nphlp/Splitergoll/docs/detection-os.md

# Diagnostic de détection d’OS

Objectif : reconnaître l’ordinateur à partir de sa connexion, sans logiciel
compagnon permanent ni changement manuel d’OS. Le diagnostic observe les échanges
et annonce une hypothèse. Avec une keymap fixe, il ne change pas les couches. Le firmware
[`auto`](keymap-auto.md) applique désormais la décision USB dans un profil expérimental.

Tous les fichiers de cette étude sont dans `diagnostics/os-signature/` :
`firmware/` pour la capture embarquée, `snippets/` pour son activation, `tests/`
pour le stockage et `capture.sh`, `capture.ps1`, `check.awk` pour les lecteurs.
L’observateur USB et le classifieur partagés sont dans `keyboard/src/os_detection/`,
leurs interfaces dans `keyboard/include/splitergoll/` et leurs tests dans `keyboard/tests/`.

## Préparer V1 en USB

```sh
make build wire macos usb-trace
make flash wire macos left usb-trace
```

La droite garde son firmware `wire` normal de la même version. Le build produit
aussi son UF2, mais seul celui de gauche ajoute le diagnostic. Aucun reset des
réglages n’est nécessaire. Sur Windows, conserver cette même keymap pour comparer
exactement le même firmware, sans attendre des raccourcis macOS qu’ils soient adaptés.

La centrale conserve les 256 premiers en-têtes SETUP de huit octets de chaque
cycle USB, avec leur ordre et un horodatage local. Aucun contenu de frappe ni
clé Bluetooth n’est enregistré. Une lecture ne vide pas cette mémoire.

## Lire une capture

Sur le Mac, identifier le port série de gauche avec `ls /dev/cu.usbmodem*`,
puis utiliser son nom exact, par exemple :

```sh
make usb capture /dev/cu.usbmodem123
```

Sous Windows, copier uniquement [capture.ps1](../diagnostics/os-signature/capture.ps1)
dans le dossier de son choix, par exemple `Documents/Splitergoll`. Aucun sous-dossier
ni autre fichier du dépôt n’est nécessaire. Ouvrir PowerShell dans ce dossier,
trouver le port gauche dans le Gestionnaire de périphériques, puis lancer :

```powershell
powershell -NoProfile -ExecutionPolicy Bypass -File .\capture.ps1 -Port COM3
```

L’option `Bypass` permet ce lancement si la politique d’exécution bloque les scripts.
Elle reste limitée au processus PowerShell lancé, sans changer la politique enregistrée.
Ce lecteur ne demande pas de terminal administrateur. Voir [la documentation Microsoft](https://learn.microsoft.com/en-us/powershell/module/microsoft.powershell.core/about/about_powershell_exe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).

Remplacer les exemples de ports par ceux réellement présents. Fermer les autres
lecteurs série. Brancher la droite sur un chargeur USB pendant cette identification
évite de confondre deux ports. Aucun logiciel supplémentaire n’est nécessaire pour
le lecteur PowerShell, le pilote série natif doit être disponible.

La capture Windows apparaît directement dans le dossier courant, sous le nom
`windows-AAAA-MM-JJ-HH-MM-SS-xxxxxxxx.txt`, avec date UTC. C’est ce fichier qu’il faut
transmettre. Le chemin du script ne détermine pas celui de la capture.
Sur macOS/Linux, `make usb capture` conserve ses fichiers dans `.local/usb-traces/`.
Le lecteur attend au plus 15 secondes la réponse après sa demande et refuse une
capture tronquée, désordonnée ou signalant des pertes. Seules les requêtes mémorisées
sont restituées, pas les frappes.

## Comparer Mac et Windows

1. Garder les mêmes UF2, câbles et branchement direct, sans hub pour le premier essai.
2. Débrancher les deux USB de V1 pour repartir d’un démarrage neuf.
3. Brancher les USB à l’ordinateur testé, attendre cinq secondes, puis lire la gauche.
4. Répéter trois fois sur le Mac, puis trois fois sur Windows. Ne pas taper pendant la capture.
5. Comparer les requêtes, leurs paramètres et leur ordre. Les temps seuls ne sont pas une signature fiable.

Une fois des différences reproductibles identifiées, tester aussi Linux, les hubs,
la reconnexion et le réveil pour élargir la validation de la reconnaissance automatique.

## Limites du diagnostic

Le port série ajoute une interface CDC ACM aux descripteurs USB. Les premières
signatures décrivent donc un clavier instrumenté, pas encore le firmware normal.
Le lecteur peut lui-même ajouter des requêtes série. Il faudra isoler ces échanges
et revalider les signatures sans cette interface avant d’en faire une fonctionnalité.
Un échec d’énumération qui empêche l’apparition du port n’est pas lisible par ce canal.
Sur V1, le firmware normal fonctionne sur macOS mais ne produit aucune saisie sur
Windows. Utiliser [la capture côté Windows](capture-usb-windows.md) avec `-UsbEvents`
pour étudier ce cas sans ajouter d’interface série au clavier.

## Résultats sur V1

Les cinq captures Mac contiennent chacune 24 requêtes, les cinq Windows 57,
58, 57, 53 et 53. Aucun rejet ni perte n’est signalé. Le lecteur PowerShell fonctionne sur
le PC. Ces captures de référence sont conservées dans `.local/usb-traces/`.

Les motifs de noms sont cohérents entre les essais. Le début de l’énumération et
les répétitions peuvent varier : la capture Windows sur le clavier commence sur 18
octets, sans sonde de 64 visible.
Les requêtes CDC sont isolées, car elles dépendent aussi du pilote et du lecteur série.

| Demande observée | Mac | PC Windows |
| --- | --- | --- |
| Début de la capture du descripteur du périphérique | 8 octets | 64 ou 18 octets selon le cycle |
| Lecture des noms du clavier | 2 octets puis lecture complète | Lectures sur 255 octets, puis 4 et complet avec CDC ou 262 sans CDC |

Le code est propre à Splitergoll, inspiré des motifs étudiés par
[QMK](https://docs.qmk.fm/features/os_detection) et
[Cormoran](https://github.com/cormoran/zmk-feature-os-detection/blob/main/docs/fingerprints.md),
puis confronté à nos captures. Aucun module externe ni changement de descripteur USB n’est ajouté.

## Comment la décision est prise

Le classifieur associe chaque sondage à sa relecture, pour le même nom et la même
langue. Deux motifs « 2 puis complet » suggèrent macOS. Windows demande deux noms
distincts sur 255 octets, avec soit un motif « 4 puis complet », soit une relecture
du même nom sur « 255 puis 262 ». Ce second motif vient de la capture du firmware
normal, sans port série. Une seule taille ou des répétitions ne suffisent pas. Les sondes
8/64 sont complémentaires : leur absence ne bloque pas la décision, leur
contradiction la rend ambiguë. Répéter un même nom ne renforce pas l’indice.
Les tailles des rapports HID et les requêtes du lecteur série sont ignorées.

Il annonce son hypothèse dès que les motifs sont suffisants, sans délai fixe.
La sélection automatique attend aussi que l’USB clavier soit prêt et que les
touches soient relâchées. Des indices insuffisants
donnent « inconnu », des motifs contradictoires donnent « ambigu ».
Un reset du bus USB ou une déconnexion efface les indices du cycle précédent.

La lecture affiche `Signature USB : hypothèse macOS` ou `Windows`. La décision est
recalculée sur l’instantané au moment de la demande de capture, pas appliquée aux couches.
L’aller-retour Mac → Windows → Mac est confirmé sur V1, sans nouveau flash entre
Windows et le retour au Mac. La sélection automatique est ensuite confirmée avec CDC.
Sans CDC, le Mac fonctionne mais Windows restait bloqué : sa capture ETW ne contient
aucun sondage sur 4 octets. Le motif « 255 puis 262 » corrige le rejeu, puis
l’utilisateur confirme la saisie et la détection Windows puis macOS avec le même
firmware normal sur V1, sans reflash entre les hôtes. Il signale ensuite un délai
irrégulier de démarrage sur Mac, même de Mac vers Mac. Ce cas reste ouvert,
sans preuve d’une ancienne sélection Windows conservée. Linux et les hubs restent à tester.
Avec `wire auto usb-trace`, une ligne `Keymap automatique appliquée` indique la
sélection réelle. Un résultat en attente signifie qu’aucun OS n’est encore activé.

Le script `.ps1` est enregistré en UTF-8 avec BOM pour les accents sous Windows
PowerShell. Les fichiers de capture restent en UTF-8 sans BOM pour leur analyse.
Le lecteur mis à jour et l’affichage des accents sont confirmés sur le PC.

## Suite Bluetooth

Le [protocole Bluetooth](detection-os-bluetooth.md) décrit le firmware `ble-trace`
et la lecture des premiers appairages et reconnexions sur Mac puis Windows.

V1 peut aussi tester le Bluetooth direct avec ses deux USB pour l’alimentation,
sans batterie. Ce sera une capture BLE distincte, pas une détection de l’OS
Bluetooth à partir du chargeur ou de l’ordinateur qui fournit son USB.

Pour revenir à l’usage normal : `make flash wire macos left`.
