nphlp/Splitergoll/docs/keymap-auto-bluetooth.md

# Keymap automatique Bluetooth

`bluetooth auto` réunit macOS et Windows avec gaming. Il utilise l’OS mémorisé
de l’appareil Bluetooth sélectionné. L’ordinateur qui alimente l’USB ne détermine
pas la keymap. Sur V1, l’utilisateur confirme la bascule entre Mac et Windows avec
la bonne keymap pour chaque appareil, avec le firmware `ble-trace`.

```sh
make build bluetooth auto
```

## Fonctionnement

Au premier appairage, le clavier observe les services demandés et
[mémorise l’OS reconnu](memoire-os.md). Aux reconnexions et après redémarrage,
il reprend exclusivement cet OS. Les appairages et enregistrements déjà créés
par notre diagnostic sont compatibles, aucun reset n’est nécessaire.

Le nouveau firmware ouvre [dix secondes de connexion](reconnexion-bluetooth.md)
au démarrage et avec le raccourci : retour des connus et accueil des nouveaux sur
un slot libre, sans détourner la saisie. L’OS est acquis directement pendant ce nouvel
appairage, le détour par un diagnostic fixe n’est plus nécessaire. Cette extension
reste à valider sur le clavier.

Une fois la connexion sécurisée et sa mémoire vérifiée, les couches du bon OS
deviennent disponibles. Les affectations sont partagées avec les profils fixes,
y compris le pavé numérique et le gaming Windows.

Un appareil sans OS mémorisé, une erreur ou un résultat inconnu laisse les touches
en attente, sans choisir Windows par défaut. La correction manuelle viendra plus tard.
La fin des touches maintenues et des comportements différés précède toute bascule.
Aucun délai fixe de détection n’est ajouté au démarrage.

Depuis la base, **L1 + clic encodeur droit**, puis relâchement, sélectionne le prochain ordinateur
actuellement connecté. Un appareil seulement appairé est ignoré. Ce raccourci est
validé sur V1 entre Mac et Windows. La [sélection automatique d’appareil](selection-appareil.md)
reste à développer.
Le profil garde la saisie Bluetooth pendant la charge USB et ses délais de veille normaux.

## Essais complémentaires

Commencer avec le port de contrôle, sans changer les appairages :

```sh
make build bluetooth auto ble-trace
make flash bluetooth auto right ble-trace
make flash bluetooth auto left ble-trace
```

Flasher chaque moitié séparément. Garder l’USB gauche au Mac, même pour Windows.
Utiliser le clavier intégré du Mac pour piloter les essais :

```sh
make ble profiles /dev/cu.usbmodem1101
make ble memory /dev/cu.usbmodem1101
make ble select /dev/cu.usbmodem1101 1
```

Adapter le port et l’index au statut réel, ici Mac 0 et Windows 1. Une fois connecté,
le clic droit doit afficher Windows. Tester Control, le gaming et le retour à sa base.
Revenir au Mac avec le même sélecteur sur 0, puis vérifier l’affichage macOS et Command.
Ne pas taper sur Splitergoll pendant les changements de destination.
Si Windows est déconnecté après la fermeture de la fenêtre, faire L1 + clic droit
pour la rouvrir avant de le reconnecter. Une sélection USB seule ne l’ouvre pas.

Le diagnostic de session Windows peut rester inconnu en reconnexion : la décision
vient de `stored=windows`, pas d’une nouvelle reconnaissance. Les essais avec
touches maintenues, redémarrage et firmware normal complètent cette validation.
V2 sur batterie, Linux et d’autres ordinateurs restent à tester.

Pour les essais actuels, suivre [le protocole de connexion](tests-connexions-bluetooth.md).
Il distingue bascule entre deux hôtes prêts, saisie immédiate, recherche d’un connu
et nouvel appairage. Le diagnostic ponctuel a une fenêtre de dix secondes, les
builds normaux trente secondes. Avec un seul hôte prêt, le raccourci sélectionne
la première autre arrivée utilisable. Avec plusieurs, il choisit le suivant déjà prêt.
