nphlp/Splitergoll/Design PCB/img/split wireless keyboard.png

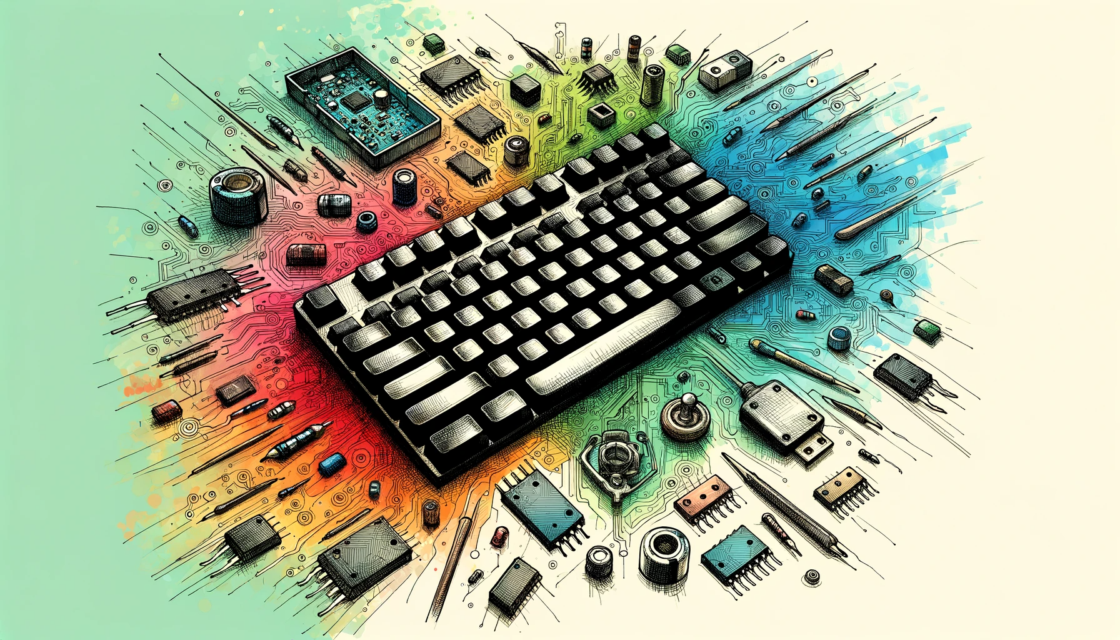
Design PCB/img/split wireless keyboard.png
