nphlp/Splitergoll/Design PCB/img/split wireless keyboard_ mini.png

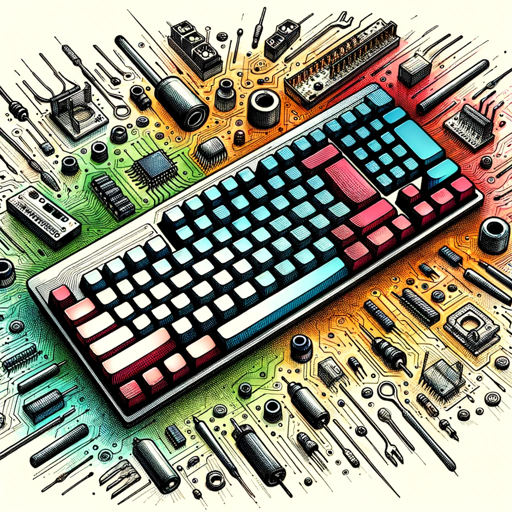
Design PCB/img/split wireless keyboard_ mini.png
