nphlp/Splitergoll/Design 3D/Splitergoll v101.3mf

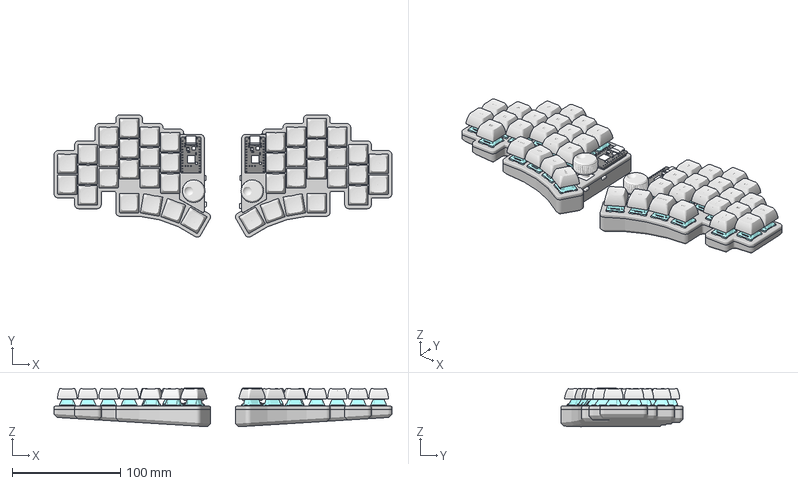
[picture p9: CAD file, 2026-10-15]
Design 3D/Splitergoll v101.3mf
311.6 x 112.8 x 35.5 mm
Barrette (1) x 2
Barrette (2) x 2
Barrette (3) x 2
Barrette x 2
Battery (L)
Battery (R)
Cache (L)
Cache (R)
Case (L)
Case (R)
Corps1 x 100
Corps10 x 2
Corps11 x 2
Corps12 x 2
Corps13 x 2
Corps14 x 2
Corps15 x 2
Corps16 x 2
Corps17 x 2
Corps18 x 2
Corps19 x 2
Corps2 x 52
Corps20 x 2
Corps21 x 2
Corps22 x 2
Corps23 x 2
Corps24 x 2
Corps25 x 2
Corps26 x 2
Corps27 x 2
Corps28 x 2
Corps29 x 2
Corps3 x 52
Corps30 x 2
Corps31 x 2
Corps32 x 2
Corps33 x 2
Corps34 x 2
Corps35 x 2
Corps38 x 2
Corps39 x 2
Corps4 x 44
Corps5 x 46
Corps7 x 2
Corps8 x 2
Corps9 x 2
Encoder (L)
Encoder (R)
Grid (L)
Grid (R)
Lettre ,
Lettre .
Lettre :
Lettre ;
Lettre A
Lettre ALT
Lettre B
Lettre BACK
Lettre C
Lettre CTRL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
