nphlp/Splitergoll/Design PCB/SplitErgoLL_v2.step

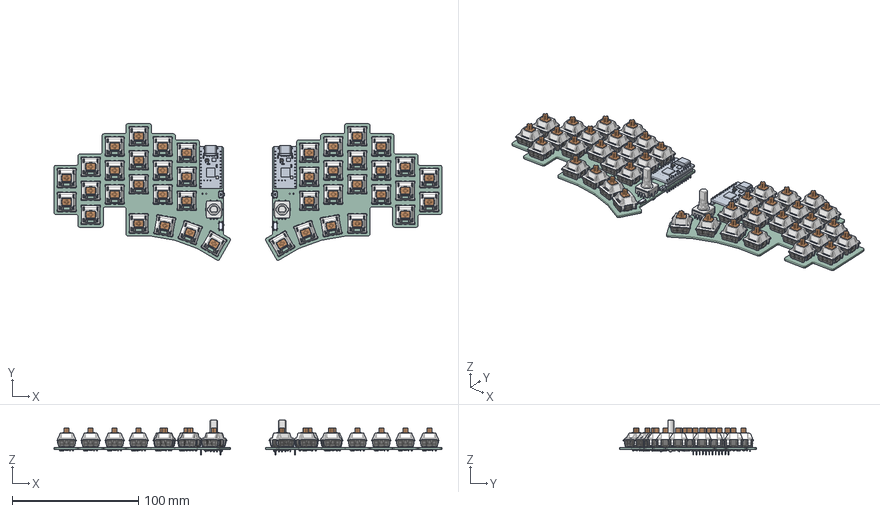
[picture p10: CAD file, 2026-10-15]
Design PCB/SplitErgoLL_v2.step
307.0 x 108.2 x 27.5 mm
SplitErgoLL_v2 PCB1
SplitErgoLL_v2 PCB2
