nphlp/Splitergoll/(list of files, cad)

Other CAD files:
design-3d/Splitergoll v101.f3z
