nphlp/Splitergoll/docs/build-local.md

# Build local

Le Makefile lance Docker, puis `west`, l’outil de build de ZMK/Zephyr.
CMake prépare la compilation et Ninja utilise le compilateur ARM pour produire
les fichiers UF2. GitHub Actions n’est pas nécessaire.
Le dossier `.github/` a été retiré : aucun workflow GitHub Actions ne fait partie
de cette branche. Son ancienne matrice `build.yaml` a également été retirée.

## Utilisation

Prérequis : Make, Bash, Docker démarré, `shasum` et un terminal macOS/Linux.
Sur Windows, utiliser WSL avec Docker. La validation Windows reste à faire.

Commande : `make build <matériel> <keymap> [debug|usb-trace|ble-trace|identity|usb-priority]`.
Le matériel et la keymap sont obligatoires, dans cet ordre. Aucun choix par défaut.

```sh
make setup
make build wire macos
make build bluetooth windows debug
```

- `setup` télécharge l’image et les sources figées.
- Le matériel `wire` choisit une sortie USB à gauche, `bluetooth` une sortie Bluetooth directe.
- La keymap doit être `auto`, `multi`, `windows`, `macos` ou `linux`.
- `auto` sélectionne macOS ou Windows avec gaming : par [signature USB](keymap-auto.md)
  en `wire`, ou par [OS mémorisé de l’appareil sélectionné](keymap-auto-bluetooth.md) en `bluetooth`.
- `windows` comprend le gaming. Les profils macOS et Linux restent sur leur OS.
- Ajouter `debug` après la keymap active les logs USB, voir [logs-usb.md](logs-usb.md).
- `identity`, réservé à `bluetooth auto`, ajoute les canaux d’[identité USB/BLE](diagnostic-identite.md)
  sur la gauche, sans saisie USB ni logs série. La droite reste normale.
- `usb-priority`, réservé à `bluetooth auto`, active la [priorité USB](priorite-usb.md)
  pour le même ordinateur déclaré par l’app. Deux interfaces HID à gauche, sans port série.
- `usb-trace`, réservé à `wire`, enregistre les requêtes de connexion de la gauche
  et affiche aussi la sélection appliquée avec `auto` : voir [le diagnostic d’OS](detection-os.md).
- `ble-trace`, réservé à `bluetooth`, garde les échanges de découverte de l’hôte
  sur la gauche. Il observe la keymap choisie au build, fixe ou `auto` : voir
  [le diagnostic Bluetooth](detection-os-bluetooth.md).
- `build` seul affiche l’aide, sans compilation ni Docker. Un choix incomplet ou invalide échoue avant Docker.
- `stop` arrête les conteneurs de build de ce checkout, en conservant les fichiers.
- `clear` les arrête puis supprime `.local/` et `dist/` pour toutes les versions.
- `make -n build bluetooth multi` affiche les commandes sans les exécuter.
- `make help` affiche l’aide colorée. Les commandes batterie sont décrites dans [batteries.md](batteries.md).

Après le premier `setup`, choisir le profil à compiler tant que les versions restent les mêmes.
Un seul `setup` prépare les deux profils. Lancer la compilation
avec `make build wire macos` ou `make build bluetooth windows`, par exemple.
Chaque profil conserve son propre dossier de sortie et ses journaux.
Après `make clear`, recommencer par `make setup`. L’image Docker reste disponible.
Le nettoyage refuse les liens symboliques et tout conteneur restant qui utilise le dépôt.

Chaque action Docker utilise un conteneur éphémère, supprimé à sa sortie grâce à `--rm`.
Chaque build explicite compile les deux moitiés du profil choisi.
Les logs restent visibles dans le terminal. Un label identifie le checkout pour
que `stop` cible ses seuls conteneurs de build.

Les quatre étapes affichent leur durée. En terminal interactif, les huit dernières
lignes défilent puis se replient après réussite. En cas d’échec, la sortie complète
est affichée. Sans terminal interactif, tous les logs défilent normalement.
Les journaux complets et les durées restent dans `.local/logs/` jusqu’au prochain `clear`.
Les validations sont vertes, les avertissements jaunes et les erreurs rouges.
Les couleurs sont désactivées sans terminal compatible ou avec `NO_COLOR=1`.

Si Docker affiche `DOCKER_INSECURE_NO_IPTABLES_RAW`, ce réglage vient de son moteur.
Il désactive certaines protections réseau iptables, pas la vérification des sources.
L’avertissement reste visible. Aucun port n’est publié par les conteneurs Splitergoll.
Voir [l’explication des mainteneurs Docker](https://github.com/moby/moby/pull/49621).
Le diagnostic sur le moteur OrbStack n’a pas identifié de réglage exposé pour
corriger ce drapeau. Ce point reste ouvert côté moteur, sans modification système.

Le build migré conserve deux avertissements du socle : `KSCAN` est déprécié et
les tap-dances ZMK émettent un avertissement de qualification `const`.
Ils restent visibles. Leur résolution est distincte de cette migration, voir
[les détails et validations](migration-zmk.md). L’avertissement GPREGRET a disparu.

Le dépôt est monté en lecture seule. Les dépendances et caches sont dans `.local/`.
Le snapshot ZMK `4dd95d7840eb`, basé sur Zephyr 4.1 avec correctifs ZMK,
et ses dépendances sont verrouillés dans `keyboard/west.yml`.
L’image officielle est figée par son digest dans `scripts/build-common.sh`.

Ces hashes identifient les commits et l’image exacts pour retrouver le même
environnement à chaque build. Cette version prépare ZMK 0.4, elle n’est pas une
release stable publiée. Le manifeste détaille 68 projets, dont 45 actifs,
pour verrouiller aussi les dépendances indirectes. L’image officielle 4.1 et
la cible `nice_nano@2.0.0//zmk` remplacent le socle 3.5 et `nice_nano_v2`.
Le [snapshot stable 0.3](firmwares-stables.md) reste récupérable dans l’historique Git pour revenir en arrière.

## Organisation

`keyboard/` regroupe les keymaps et profils dans `config/`, les shields dans
`boards/`, leur déclaration de module dans `zephyr/` et le manifeste `west.yml`.
L’étude des signatures
est séparée dans `diagnostics/os-signature/`, son firmware n’est ajouté qu’aux builds `usb-trace` et `ble-trace`.

Chaque commande a sa propre cible dans le Makefile et appelle directement son script.
Les sections séparent aide, Firmware, Batteries (bat/app) et Debug (port/usb/ble). Les mots après la
première commande sont uniquement ses arguments : `make app build` ne lance pas
le build firmware. Les scripts contrôlent leurs arguments avant toute action.
`make app`, `make bat`, `make usb` et `make ble` affichent leurs aides, de même
qu’une sous-commande erronée. Celle-ci renvoie aussi un statut d’erreur.

Les scripts se répartissent ainsi :

- `scripts/help.sh` et `terminal-colors.sh` : aide colorée et palette partagée avec les journaux.
  `make port` explique comment trouver le port série du clavier, sans ouvrir de connexion.
- `scripts/build-common.sh` : constantes de chemins et d’image, contrôles et lancement Docker.
- `scripts/build-logs.sh` : affichage des étapes, durées et journaux complets.
- `scripts/setup.sh` : préparation des dépendances.
- `scripts/build.sh` : compilation et récupération des UF2.
- `scripts/flash.sh` et `uf2-check.awk` : sélection, contrôle et copie d’un UF2 après confirmation sur macOS, voir [le flash](flash-firmware.md).
- `scripts/container.sh` : commandes `west` et contrôles dans le conteneur.
- `scripts/stop.sh` : arrêt des conteneurs de build du checkout.
- `scripts/clear.sh` : arrêt et suppression des fichiers locaux générés.
- `scripts/batteries.sh` : `make bat read` et `make bat avg`, sans Docker.
- `companion/macos/app.sh` : `make app start`, `build` et `test`.
- `diagnostics/os-signature/usb.sh` et `ble.sh` : sous-commandes de diagnostic.

Les chemins locaux sont calculés depuis le dépôt. Aucun `.env` n’est nécessaire.
Les caches CMake du nouveau rangement utilisent `build/keyboard/` dans le workspace
préparé. Les anciens caches sont conservés, un nouveau `make setup` n’est pas nécessaire.
`make build bluetooth multi` appelle `build.sh bluetooth multi`, `make bat avg` appelle
`batteries.sh avg`. Les scripts refusent les arguments qu’ils ne prennent pas en charge.

## Profils matériels

| Profil | Sortie de la gauche | Veille profonde | Batterie |
| --- | --- | --- | --- |
| `wire` | USB vers l’ordinateur | Désactivée | Reporting désactivé |
| `bluetooth` | Bluetooth direct, même pendant la charge USB | Après 10 minutes sur batterie | Reporting activé |

Dans les deux cas, la droite communique avec la gauche en BLE. Le choix de keymap
est indépendant : `multi` conserve la référence de `dongle`, les autres profils
gardent un seul OS. `keyboard/config/splitergoll.conf` contient le socle commun,
les fichiers des moitiés fixent leurs rôles, et `keyboard/config/profiles/<profil>.conf`
est ajouté en dernier via `EXTRA_CONF_FILE`. Le nom du profil est transmis
au script Docker comme argument. Les versions ZMK et l’image restent identiques.
Le build charge aussi `keyboard/config/profiles/<profil matériel>-<moitié>.conf` lorsqu’il
existe. `bluetooth-left.conf` active la récupération et le proxy de batterie sur
la centrale seulement. L’option `debug` ajoute le snippet natif `zmk-usb-logging`
au même profil. Elle a ses propres caches et sorties, sans changer les délais.
`KEYMAP_FILE` désigne `keyboard/config/keymaps/<keymap>.keymap` dans ZMK. La commande vérifie
que CMake a bien utilisé ce fichier avant d’exporter les UF2.
`make build` seul affiche l’aide. Chaque compilation demande un matériel et une keymap explicites.
`dongle` sera ajouté plus tard.

## Résultat

Chaque build crée un dossier `dist/firmware/<matériel>-<keymap>-AAAA-MM-JJ-HH-MM-SS/`,
avec un horodatage utilisant l’heure locale de la machine.
Le dossier contient :

- `splitergoll-<matériel>-<keymap>-left.uf2`
- `splitergoll-<matériel>-<keymap>-right.uf2`
- `SHA256SUMS` : empreintes des deux firmwares
- `build-info.txt` : matériel, keymap, diagnostic et identifiant de l’environnement utilisé

Avec `debug`, le nom du profil porte le suffixe `-debug` dans le dossier et les UF2,
par exemple `bluetooth-macos-debug-AAAA-MM-JJ-HH-MM-SS/` et
`splitergoll-bluetooth-macos-debug-left.uf2`. Le nom inclut toujours la keymap,
y compris `multi`, pour éviter de confondre les firmwares.

Si deux exports utilisent la même seconde, le second échoue sans écraser le premier.
Relancer la même commande de build avec son profil pour obtenir un nouvel horodatage.

Les caches sont séparés par version, matériel, keymap, diagnostic et moitié. Les dépendances modifiées
bloquent le build. Les rôles USB/BLE sont contrôlés après compilation.
Le build ne flashe rien et ne supprime aucun appairage.

Validation de migration : le setup passe sur le Mac ARM et les 32 UF2 compilent,
soit les deux matériels, quatre keymaps, normal/debug et deux moitiés.
Rôles, sorties, délais, proxy batterie, logs, bootloader, partitions, empreintes
et blocs UF2 sont contrôlés. Les keymaps compilées, macros et paramètres matériels
sont comparés au snapshot stable. Le nouveau verrouillage des couches est désactivé
pour conserver leur comportement précédent.

V1 en `wire macos` est flashé et les essais rapportés sont positifs : voir
[les essais wire](tests-wire.md). Les autres profils restent à tester.
Sur V2 après migration, les deux niveaux de [batterie](batteries.md), la reprise
après inactivité et le réveil par la gauche sont aussi rapportés sur batterie.
La droite ne réveille pas la centrale en [veille profonde](veille.md).
La première frappe et toutes les sources de réveil restent à vérifier séparément.
L’arrêt avec `stop` pendant un build reste aussi à valider.
Voir [le matériel](configuration-materielle.md), [la keymap](keymap.md) et
[les tâches restantes](TODO.md).
