nphlp/Splitergoll/archives/firmware/zmk-0.3.0/bluetooth-macos-debug-2026-10-16-15-56-31/build-info.txt

profile=bluetooth
hardware_profile=bluetooth
keymap_profile=macos
build_mode=debug
variant=bluetooth-macos-debug
environment=000788d0acac6ba53d583ed289150c28d0d5356915775c4e11ddb66e7590deda
image=zmkfirmware/zmk-build-arm:3.5@sha256:0979a8de325e3d822e48bd8d1d9efaee2984ad3750253119f920a342f0ce5cde
