nphlp/Splitergoll/design-pcb/SplitErgoLL_v2.kicad_pcb

## KiCad design design-pcb/SplitErgoLL_v2.kicad_pcb (2026-10-21)

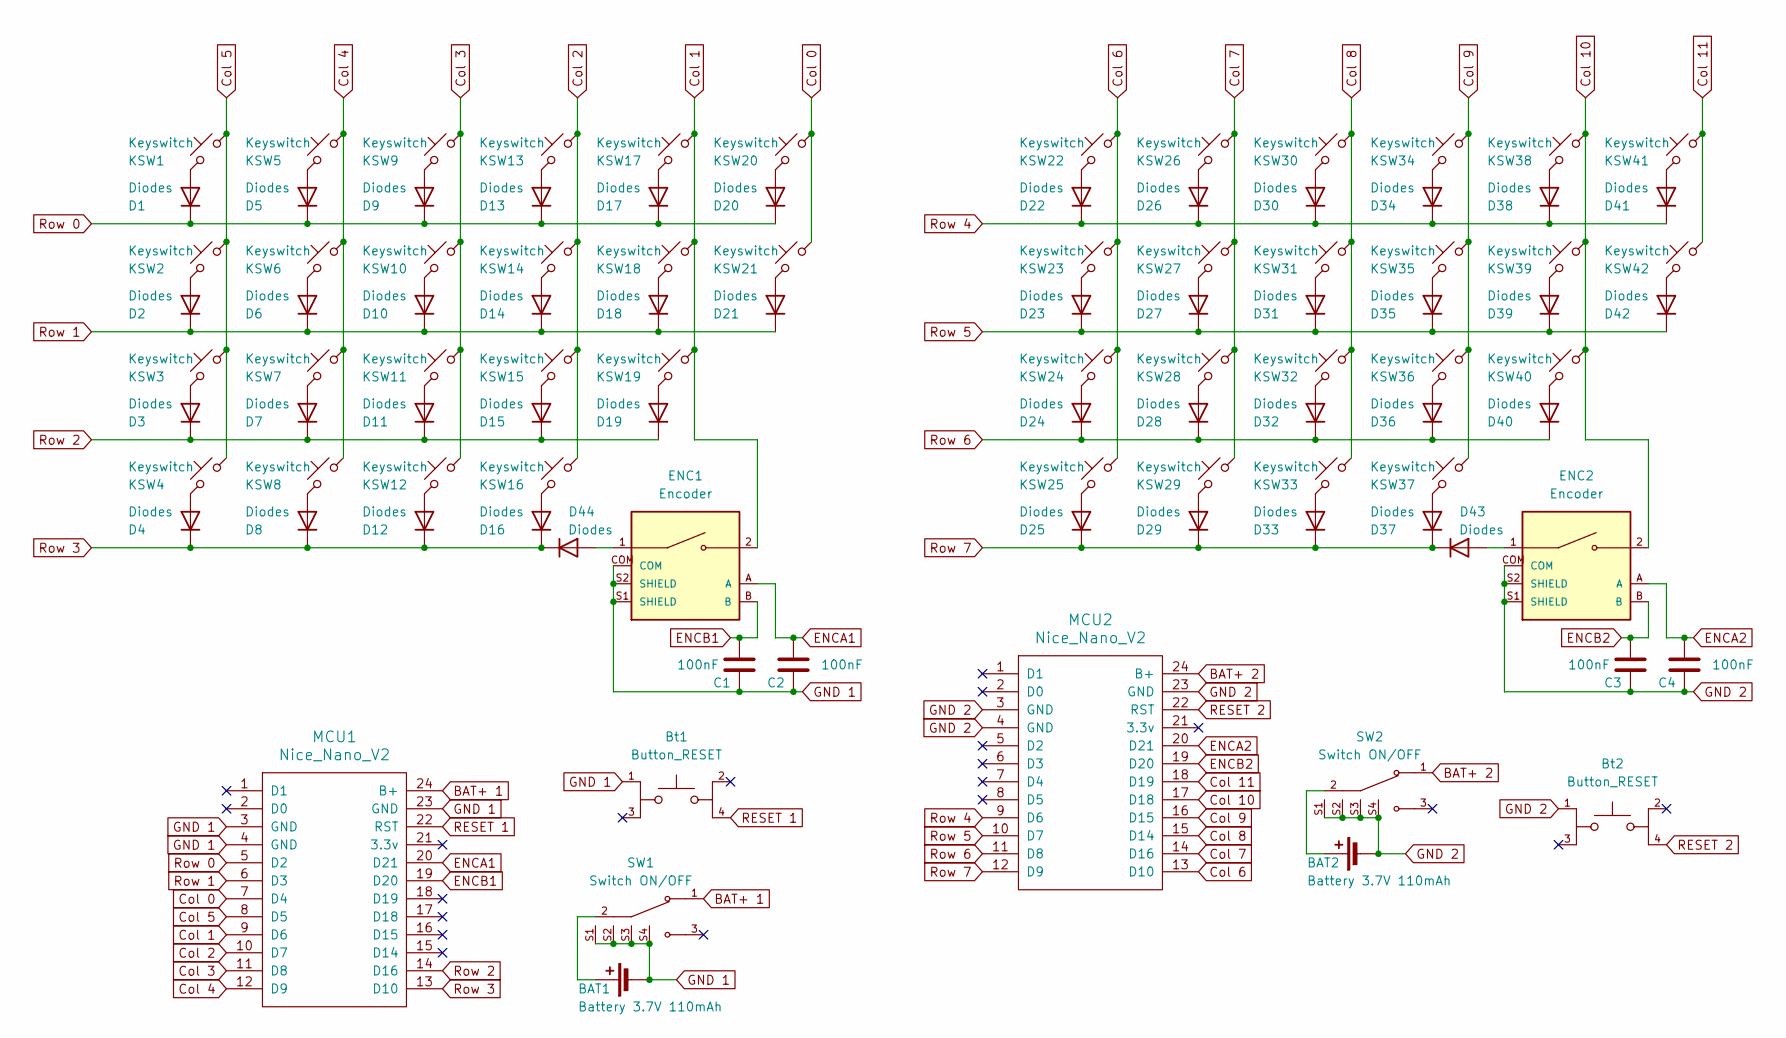
[picture p11: schematic SplitErgoLL_v2.kicad_sch]

Parts:
BAT1, BAT2: Battery 3.7V 110mAh; Battery_PINs
Bt1, Bt2: Button_RESET; PARTREV A
C1, C2, C3, C4: 100nF; Capacitor_SMD
D1, D2, D3, D4, D5, D6, D7, D8, D9, D10, D11, D12, D13, D14, D15, D16, D17, D18, D19, D20, D21, D22, D23, D24, D25, D26, D27, D28, D29, D30, D31, D32, D33, D34, D35, D36, D37, D38, D39, D40, D41, D42, D43, D44: Diodes; Diode_SMD
ENC1, ENC2: Encoder; PARTREV Rev. 09/19
KSW1, KSW2, KSW3, KSW4, KSW5, KSW6, KSW7, KSW8, KSW9, KSW10, KSW11, KSW12, KSW13, KSW14, KSW15, KSW16, KSW17, KSW18, KSW19, KSW20, KSW21, KSW22, KSW23, KSW24, KSW25, KSW26, KSW27, KSW28, KSW29, KSW30, KSW31, KSW32, KSW33, KSW34, KSW35, KSW36, KSW37, KSW38, KSW39, KSW40, KSW41, KSW42: Keyswitch; Keyswitch_MX
MCU1, MCU2: Nice_Nano_V2; Nice_Nano_v2
SW1, SW2: Switch ON/OFF; Switch_ON_OFF; PARTREV A

Connections:
BAT+ 1: MCU1.24 (B+), SW1.1
BAT+ 2: MCU2.24 (B+), SW2.1
Col 0: KSW1.2, KSW2.2, KSW3.2, KSW4.2, MCU1.8 (D5)
Col 1: KSW5.2, KSW6.2, KSW7.2, KSW8.2, MCU1.12 (D9)
Col 2: KSW9.2, KSW10.2, KSW11.2, KSW12.2, MCU1.11 (D8)
Col 3: KSW13.2, KSW14.2, KSW15.2, KSW16.2, MCU1.10 (D7)
Col 4: ENC1.2, KSW17.2, KSW18.2, KSW19.2, MCU1.9 (D6)
Col 5: KSW20.2, KSW21.2, MCU1.7 (D4)
Col 6: KSW22.2, KSW23.2, KSW24.2, KSW25.2, MCU2.13 (D10)
Col 7: KSW26.2, KSW27.2, KSW28.2, KSW29.2, MCU2.14 (D16)
Col 8: KSW30.2, KSW31.2, KSW32.2, KSW33.2, MCU2.15 (D14)
Col 9: KSW34.2, KSW35.2, KSW36.2, KSW37.2, MCU2.16 (D15)
Col 10: ENC2.2, KSW38.2, KSW39.2, KSW40.2, MCU2.17 (D18)
Col 11: KSW41.2, KSW42.2, MCU2.18 (D19)
ENCA1: C2.1, ENC1.A, MCU1.20 (D21)
ENCA2: C4.1, ENC2.A, MCU2.20 (D21)
ENCB1: C1.1, ENC1.B, MCU1.19 (D20)
ENCB2: C3.1, ENC2.B, MCU2.19 (D20)
GND 1: BAT1.2 (-), Bt1.1, C1.2, C2.2, ENC1.COM, ENC1.S1 (SHIELD), ENC1.S2 (SHIELD), MCU1.3 (GND), MCU1.4 (GND), MCU1.23 (GND), SW1.S1, SW1.S2, SW1.S3, SW1.S4; also elsewhere on the board
GND 2: BAT2.2 (-), Bt2.1, C3.2, C4.2, ENC2.COM, ENC2.S1 (SHIELD), ENC2.S2 (SHIELD), MCU2.3 (GND), MCU2.4 (GND), MCU2.23 (GND), SW2.S1, SW2.S2, SW2.S3, SW2.S4; also elsewhere on the board
unnamed 20: BAT1.1 (+), SW1.2; also elsewhere on the board
unnamed 21: BAT2.1 (+), SW2.2; also elsewhere on the board
unnamed: D1.2 (A), KSW1.1
unnamed: D2.2 (A), KSW2.1
unnamed: D3.2 (A), KSW3.1
unnamed: D4.2 (A), KSW4.1
unnamed: D5.2 (A), KSW5.1
unnamed: D6.2 (A), KSW6.1
unnamed: D7.2 (A), KSW7.1
unnamed: D8.2 (A), KSW8.1
unnamed: D9.2 (A), KSW9.1
unnamed: D10.2 (A), KSW10.1
unnamed: D11.2 (A), KSW11.1
unnamed: D12.2 (A), KSW12.1
unnamed: D13.2 (A), KSW13.1
unnamed: D14.2 (A), KSW14.1
unnamed: D15.2 (A), KSW15.1
unnamed: D16.2 (A), KSW16.1
unnamed: D17.2 (A), KSW17.1
unnamed: D18.2 (A), KSW18.1
unnamed: D19.2 (A), KSW19.1
unnamed: D20.2 (A), KSW20.1
unnamed: D21.2 (A), KSW21.1
unnamed: D22.2 (A), KSW22.1
unnamed: D23.2 (A), KSW23.1
unnamed: D24.2 (A), KSW24.1
unnamed: D25.2 (A), KSW25.1
unnamed: D26.2 (A), KSW26.1
unnamed: D27.2 (A), KSW27.1
unnamed: D28.2 (A), KSW28.1
unnamed: D29.2 (A), KSW29.1
unnamed: D30.2 (A), KSW30.1
unnamed: D31.2 (A), KSW31.1
unnamed: D32.2 (A), KSW32.1
unnamed: D33.2 (A), KSW33.1
unnamed: D34.2 (A), KSW34.1
unnamed: D35.2 (A), KSW35.1
unnamed: D36.2 (A), KSW36.1
unnamed: D37.2 (A), KSW37.1
unnamed: D38.2 (A), KSW38.1
unnamed: D39.2 (A), KSW39.1
unnamed: D40.2 (A), KSW40.1
unnamed: D41.2 (A), KSW41.1
unnamed: D42.2 (A), KSW42.1
unnamed: D43.2 (A), ENC2.1
unnamed: D44.2 (A), ENC1.1
RESET 1: Bt1.4, MCU1.22 (RST)
RESET 2: Bt2.4, MCU2.22 (RST)
Row 0: D1.1 (K), D5.1 (K), D9.1 (K), D13.1 (K), D17.1 (K), D20.1 (K), MCU1.5 (D2)
Row 1: D2.1 (K), D6.1 (K), D10.1 (K), D14.1 (K), D18.1 (K), D21.1 (K), MCU1.6 (D3)
Row 2: D3.1 (K), D7.1 (K), D11.1 (K), D15.1 (K), D19.1 (K), MCU1.14 (D16)
Row 3: D4.1 (K), D8.1 (K), D12.1 (K), D16.1 (K), D44.1 (K), MCU1.13 (D10)
Row 4: D22.1 (K), D26.1 (K), D30.1 (K), D34.1 (K), D38.1 (K), D41.1 (K), MCU2.9 (D6)
Row 5: D23.1 (K), D27.1 (K), D31.1 (K), D35.1 (K), D39.1 (K), D42.1 (K), MCU2.10 (D7)
Row 6: D24.1 (K), D28.1 (K), D32.1 (K), D36.1 (K), D40.1 (K), MCU2.11 (D8)
Row 7: D25.1 (K), D29.1 (K), D33.1 (K), D37.1 (K), D43.1 (K), MCU2.12 (D9)

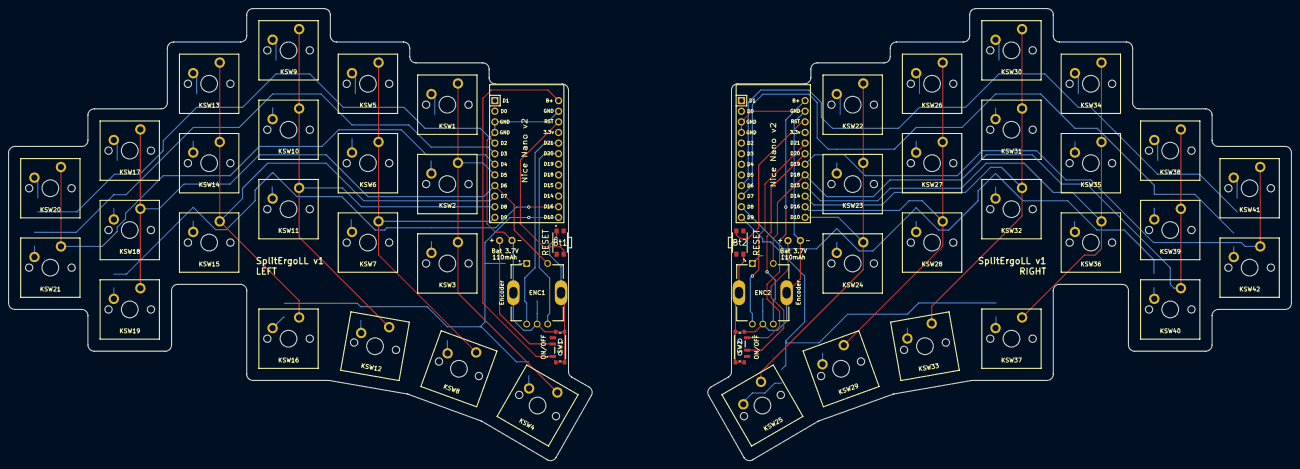
[picture p12: board SplitErgoLL_v2.kicad_pcb from above]

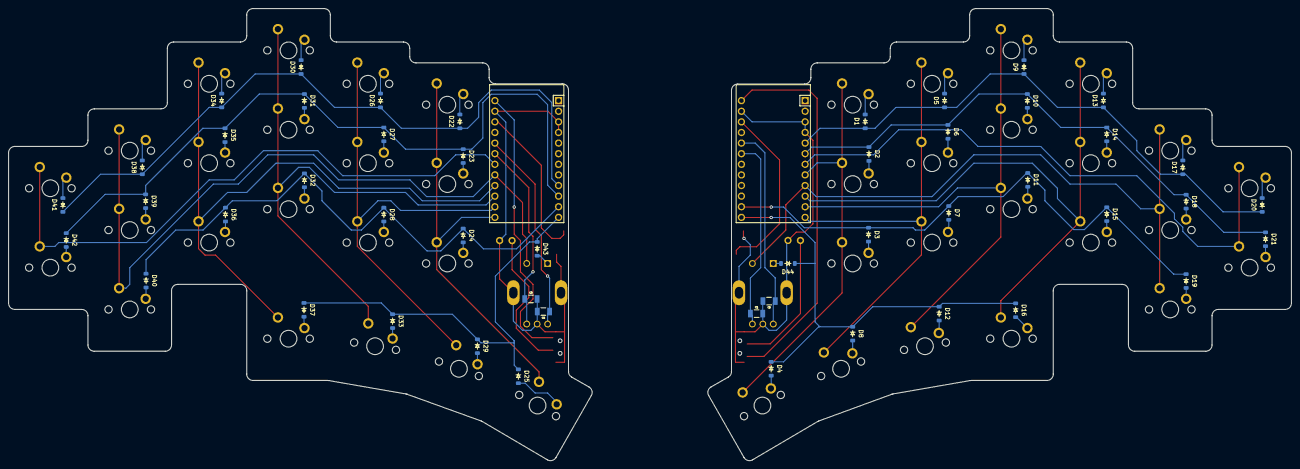
[picture p13: board SplitErgoLL_v2.kicad_pcb from below]

Board: 2 copper layers, 307.0 x 108.2 mm, 100 parts (48 on the bottom side), 76 nets.

Other parts of the board:
Bat 3.7V, Bat 3.7V#2: 110mAh; Battery_PINs

Their connections:
GND 1: Bat 3.7V#2.2 (-); also elsewhere on the board
GND 2: Bat 3.7V.2 (-); also elsewhere on the board
unnamed 20: Bat 3.7V#2.1 (+); also elsewhere on the board
unnamed 21: Bat 3.7V.1 (+); also elsewhere on the board
