nphlp/Splitergoll/diagnostics/os-signature/firmware/ble_trace_profiles.c

// Contrôle explicite d’emplacements ZMK depuis le diagnostic, sans effacement de bonds.
#include "ble_profile_control.h"
#include "trace_console.h"
#include <stdio.h>
#include <string.h>
#include <errno.h>
#include <zephyr/bluetooth/bluetooth.h>
#include <zephyr/bluetooth/conn.h>
#include <zephyr/kernel.h>
#include <zmk/ble.h>
#include <zmk/event_manager.h>
#include <zmk/events/position_state_changed.h>
#include <zmk/events/keycode_state_changed.h>
#include <zmk/events/sensor_event.h>
#include <zmk/hid.h>
#include <zmk/matrix.h>
#if defined(CONFIG_SPLITERGOLL_BLE_AUTO)
#include <splitergoll/ble_auto.h>
#include <splitergoll/ble_reconnect.h>
#endif

#if defined(CONFIG_SPLITERGOLL_BLE_RECONNECT)
#define BLE_PROFILE_VERSION "6"
#else
#define BLE_PROFILE_VERSION "2"
#endif

BUILD_ASSERT(ZMK_BLE_PROFILE_COUNT <= BLE_PROFILE_LIMIT);
BUILD_ASSERT(ZMK_KEYMAP_LEN <= 64);
#if !defined(CONFIG_SPLITERGOLL_BLE_AUTO)
static struct ble_profile_activity activity;
K_MUTEX_DEFINE(selection_mutex);

int __real_zmk_event_manager_raise(zmk_event_t *event);

// Sérialise les événements de frappe avec la sélection, sans consommer ni modifier les événements.
int __wrap_zmk_event_manager_raise(zmk_event_t *event) {
    const struct zmk_position_state_changed *position = as_zmk_position_state_changed(event);
    bool input = position != NULL || as_zmk_keycode_state_changed(event) != NULL ||
                 as_zmk_sensor_event(event) != NULL;
    if (!input) return __real_zmk_event_manager_raise(event);
    k_mutex_lock(&selection_mutex, K_FOREVER);
    uint32_t now_ms = k_uptime_get_32();
    if (position != NULL) {
        ble_profile_position(&activity, position->position, position->state, now_ms);
    } else {
        ble_profile_touch(&activity, now_ms);
    }
    int result = __real_zmk_event_manager_raise(event);
    k_mutex_unlock(&selection_mutex);
    return result;
}

#endif

// Les commandes et les événements partagent le verrou du sélecteur lorsque auto est actif.
static void lock_selection(void) {
#if defined(CONFIG_SPLITERGOLL_BLE_AUTO)
    splitergoll_ble_auto_lock();
#else
    k_mutex_lock(&selection_mutex, K_FOREVER);
#endif
}

// Libère le même verrou, y compris après un refus de mutation.
static void unlock_selection(void) {
#if defined(CONFIG_SPLITERGOLL_BLE_AUTO)
    splitergoll_ble_auto_unlock();
#else
    k_mutex_unlock(&selection_mutex);
#endif
}

// Le garde actif est celui qui observe réellement les touches dans ce firmware.
static bool input_busy(bool hid_busy) {
#if defined(CONFIG_SPLITERGOLL_BLE_AUTO)
    ARG_UNUSED(hid_busy);
    return splitergoll_ble_auto_busy();
#else
    return ble_profile_input_busy(&activity, hid_busy, k_uptime_get_32());
#endif
}

// Ne lit que les états HID en RAM, jamais les frappes dans les traces.
static bool report_nonempty(const void *body, size_t length) {
    const uint8_t *bytes = body;
    for (size_t i = 0; i < length; i++) if (bytes[i] != 0) return true;
    return false;
}

struct bond_check {
    bt_addr_le_t peer;
    bool remains;
};

// Vérifie localement la suppression native sans exporter l’identité de l’ordinateur.
static void find_bond(const struct bt_bond_info *info, void *context) {
    struct bond_check *check = context;
    if (bt_addr_le_eq(&info->addr, &check->peer)) check->remains = true;
}

// Exige un index exact et déjà sélectionné, sans bascule implicite ni effacement global.
void splitergoll_ble_forget_command(const struct device *uart, const char *frame) {
    int profile = -1, error = 0;
    const char *status = "invalid";
    lock_selection();
    if (strlen(frame) == 8 && strncmp(frame, "!CLEAR ", 7) == 0 && frame[7] >= '0' && frame[7] <= '9') {
        profile = frame[7] - '0';
        bool busy = input_busy(
            zmk_hid_get_explicit_mods() != 0 ||
            report_nonempty(&zmk_hid_get_keyboard_report()->body, sizeof(zmk_hid_get_keyboard_report()->body)) ||
            report_nonempty(&zmk_hid_get_consumer_report()->body, sizeof(zmk_hid_get_consumer_report()->body)));
        if (profile >= ZMK_BLE_PROFILE_COUNT || profile != zmk_ble_active_profile_index()) {
            status = "mismatch";
        } else if (busy) {
            status = "busy";
        } else if (zmk_ble_profile_is_open(profile)) {
            status = "empty";
        } else {
            struct bond_check check = {.peer = *zmk_ble_profile_address(profile)};
            zmk_ble_clear_bonds();
            bt_foreach_bond(BT_ID_DEFAULT, find_bond, &check);
            error = zmk_ble_profile_is_open(profile) && !check.remains ? 0 : -EIO;
            status = !error ? "ok" : "failed";
        }
    }
    unlock_selection();
    char line[150];
    if (!trace_send_line(uart, "BLEFORGET BEGIN version=1\n")) return;
    snprintf(line, sizeof(line), "BLEFORGET RESULT index=%d status=%s error=%d\n", profile, status, error);
    if (trace_send_line(uart, line)) trace_send_line(uart, "BLEFORGET END\n");
}

// Le seul appel de mutation est le sélecteur natif ZMK, aucune clé n’est supprimée ou copiée.
void splitergoll_ble_profile_command(const struct device *uart, char command) {
    lock_selection();
    uint16_t open_mask = 0;
    for (unsigned i = 0; i < ZMK_BLE_PROFILE_COUNT; i++) {
        if (zmk_ble_profile_is_open(i)) {
            open_mask |= 1u << i;
        }
    }
    bool hid_busy = zmk_hid_get_explicit_mods() != 0 ||
                    report_nonempty(&zmk_hid_get_keyboard_report()->body,
                                    sizeof(zmk_hid_get_keyboard_report()->body)) ||
                    report_nonempty(&zmk_hid_get_consumer_report()->body,
                                    sizeof(zmk_hid_get_consumer_report()->body));
    bool busy = input_busy(hid_busy);
    unsigned active = zmk_ble_active_profile_index();
    struct ble_profile_choice choice = ble_profile_choose(command, ZMK_BLE_PROFILE_COUNT,
                                                          active, open_mask, busy);
    const char *status;
    switch (choice.result) {
        case BLE_PROFILE_OK: status = "ok"; break;
        case BLE_PROFILE_BUSY: status = "busy"; break;
        case BLE_PROFILE_FULL: status = "full"; break;
        default: status = "invalid"; break;
    }
    int error = 0;
    bool changed = false;
    if (choice.result == BLE_PROFILE_OK && choice.change) {
        error = zmk_ble_prof_select(choice.target);
        if (error) {
            status = "failed";
        } else {
            changed = true;
        }
    }
    unlock_selection();
    char line[170];
    snprintf(line, sizeof(line), "BLEPROFILE BEGIN version=" BLE_PROFILE_VERSION " count=%u active=%d save_delay_ms=%u\n",
             ZMK_BLE_PROFILE_COUNT, zmk_ble_active_profile_index(), CONFIG_ZMK_SETTINGS_SAVE_DEBOUNCE);
    if (!trace_send_line(uart, line)) {
        return;
    }
    for (unsigned i = 0; i < ZMK_BLE_PROFILE_COUNT; i++) {
        snprintf(line, sizeof(line), "BLEPROFILE SLOT index=%u paired=%u connected=%u\n",
                 i, !zmk_ble_profile_is_open(i), zmk_ble_profile_is_connected(i));
        if (!trace_send_line(uart, line)) {
            return;
        }
    }
#if defined(CONFIG_SPLITERGOLL_BLE_RECONNECT)
    struct ble_reconnect_status reconnect = splitergoll_ble_reconnect_status();
    snprintf(line, sizeof(line), "BLEPROFILE WINDOW ready=%u remaining_ms=%u advertising=%u known=%u connected=%u error=%d\n",
             reconnect.ready, reconnect.remaining_ms, reconnect.advertising,
             reconnect.known, reconnect.connected, reconnect.error);
    if (!trace_send_line(uart, line)) return;
    struct ble_auto_policy_status policy = splitergoll_ble_auto_policy_status();
    snprintf(line, sizeof(line), "BLEPROFILE POLICY active=%u without_host=%u loaded=%u saved=%u remembered=%d restoring=%u error=%d\n",
             reconnect.active, reconnect.without_host, policy.loaded, policy.saved,
             policy.remembered, policy.restoring, policy.save_error);
    if (!trace_send_line(uart, line)) return;
#endif
    snprintf(line, sizeof(line), "BLEPROFILE RESULT command=%c status=%s selected=%d changed=%u error=%d\n",
             command, status, zmk_ble_active_profile_index(), changed, error);
    if (trace_send_line(uart, line)) {
        trace_send_line(uart, "BLEPROFILE END\n");
    }
}
