nphlp/Splitergoll/(commit log)

2026-10-15 chore(history): regroupe l'historique de dongle
2026-10-15 feat(build): ajoute les commandes stop et clear
2026-10-15 feat(build): affiche les étapes et leur durée
2026-10-15 fix(power): déclare la matrice comme source de réveil
2026-10-15 refactor(build): clarifie le nommage des firmwares
2026-10-15 docs(wire): documente les essais usb sur macos
2026-10-15 refactor(keymap): sépare les profils et archive la keymap historique
2026-10-15 fix(build): exige le matériel et la keymap
2026-10-15 docs(todo): précise les prochains chantiers
2026-10-16 feat(flash): clarifie la sélection et la confirmation
2026-10-17 refactor(firmware): sépare le clavier du diagnostic des signatures os
2026-10-17 feat(usb): ajoute le diagnostic des signatures d’os
2026-10-17 feat(keymap): ajoute la sélection automatique en usb
2026-10-18 perf(usb): accélère l’activation initiale de la keymap
2026-10-19 perf(usb): déclenche la sélection d’os sur les événements
2026-10-19 chore(repo): retire les archives et la configuration github
2026-10-20 feat(diagnostics): ajoute un classifieur ble hors ligne
    Ajoute les traces BLE, les lecteurs Mac et Windows et le contrôle explicite des emplacements. Prépare le classifieur C et ses tests hors ligne, sans sélection de keymap ni mémoire d’OS dans le firmware.
2026-10-20 docs(bluetooth): précise la sélection des appareils et la mémoire d’os
2026-10-20 feat(diagnostics): ajoute le suivi et la sélection des hôtes ble
2026-10-20 feat(bluetooth): mémorise l’os de chaque appareil appairé
2026-10-20 feat(bluetooth): sélectionne la keymap depuis l’os mémorisé
2026-10-20 feat(bluetooth): ajoute la bascule entre appareils connectés
2026-10-20 feat(connections): prépare les fenêtres bluetooth
2026-10-21 feat(bluetooth): ajoute les fenêtres de reconnexion des appareils connus
2026-10-21 feat(power): ajuste la veille et documente la charge
2026-10-21 docs(macos): décrit l’application compagnon
2026-10-21 feat(batteries): simplifie l’app macos et accélère les mesures
2026-10-21 refactor(repo): renomme les dossiers de ressources en kebab-case
2026-10-21 refactor(cli): simplifie les commandes make et leurs aides
2026-10-21 chore(images): renomme les photos et retire les métadonnées
2026-10-22 feat(bluetooth): ouvrir une fenetre commune de connexion
2026-10-22 feat(macos): ameliorer la charge et la mise a jour de l'app
2026-10-22 fix(bluetooth): fiabiliser les bascules et valider les reconnexions
2026-10-22 feat(bluetooth): memoriser la destination et gerer la recherche sans hote
2026-10-22 fix(bluetooth): fiabiliser la reprise et la memorisation des appareils
2026-10-23 docs(plan): cadrer la reprise et le gaming usb
2026-10-23 test(firmware): couvrir les connexions et ajouter le journal d’activité
2026-10-24 feat(clavier): isoler le wire et choisir le clavier suivi
2026-10-26 feat(identity): comparer les declarations usb et bluetooth
